will211/ESOE_Capstone_Embedded_System/README.md

# ESOE_Capstone_Embedded_System
 A self propelled boat campaign

 Route plan of autonomous ship via an infrared distance sensor
