will211/ESOE_Capstone_Embedded_System/Final-Report.pdf

# 工科專論期末報告格式

組員: 凃皓瑋 B06505001 朱紹勳 B06501018 陳威宇 B06204013 黃智遠 B06505049

1. 分工表:

組員 凃皓瑋: 船模設計

組員 朱紹勳: 程式、電路設計

組員 陳威宇: 程式、測試

組員 黃智遠: 打雜

2. 船體設計:

乾舷約為 5.15cm

吃水 1020g 時 GM 約為 2.13cm

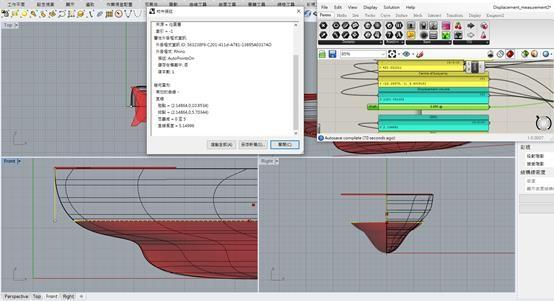
[picture p1: figure]
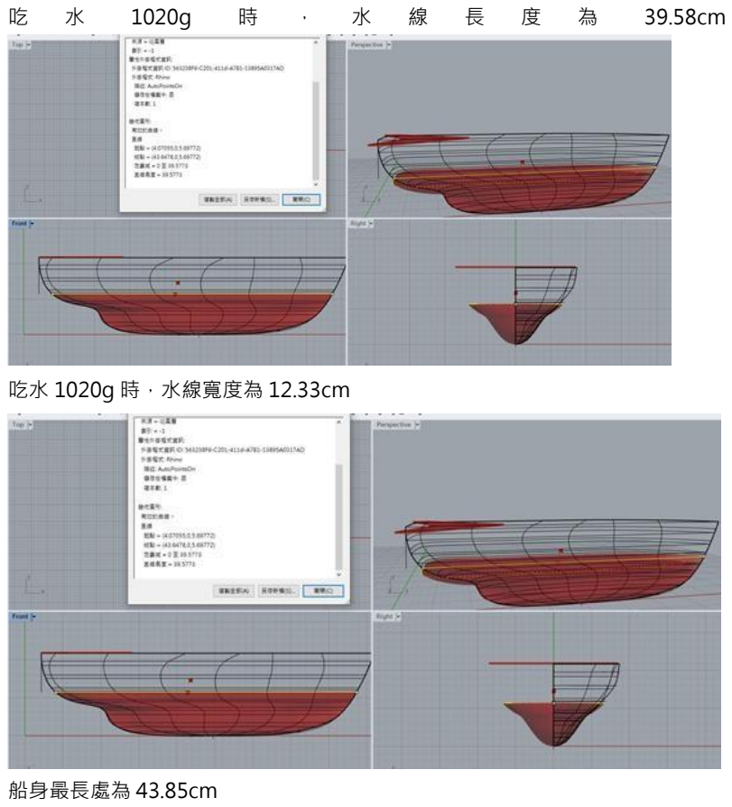
[picture p2: page 2]

吃 | 水 | 1020g | 時 | ， | 水 | 線 | 長 | 度 | 為 | 39.58cm

吃水 1020g 時，水線寬度為 12.33cm

船身最長處為 43.85cm

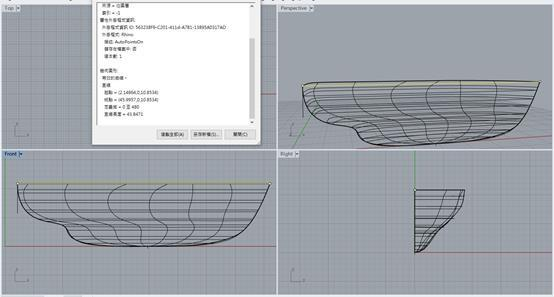
[picture p3: figure]

船體設計為下窄上寬，原因是為了保留螺槳空間以及增加 right arm 大小。

電路設計:
我們使用的 STM32F303RE 開發版，主要負責以下兩種功能: 超聲波感應與馬達 控制。

我們總共使用了五個超聲波感應器，為了避免超聲波錯誤的接收到其他發出的 trigger 信號而干擾，船頭設置一個(與船隻方向相同)，船身右前、左前、右後、 左後各設置一個(與船隻方向成 90 度)，彼此位置盡量拉開。

設計中，我們總共使用了七個 Timer，其中的五個 Timer: Timer2、Timer3、 Timer15、Timer16、Timer4，分別負責一個超聲波感測器的 echo 信號， Timer1 負責 interrupt 與 trigger 信號的發送；Timer8 下的兩個 channel 負責 兩個螺槳的旋轉。
以下表格顯示五個超聲波與對應 Timer，和 5V, Ground, trigger, echo 與 STM32 開發版的連接 pin 腳。

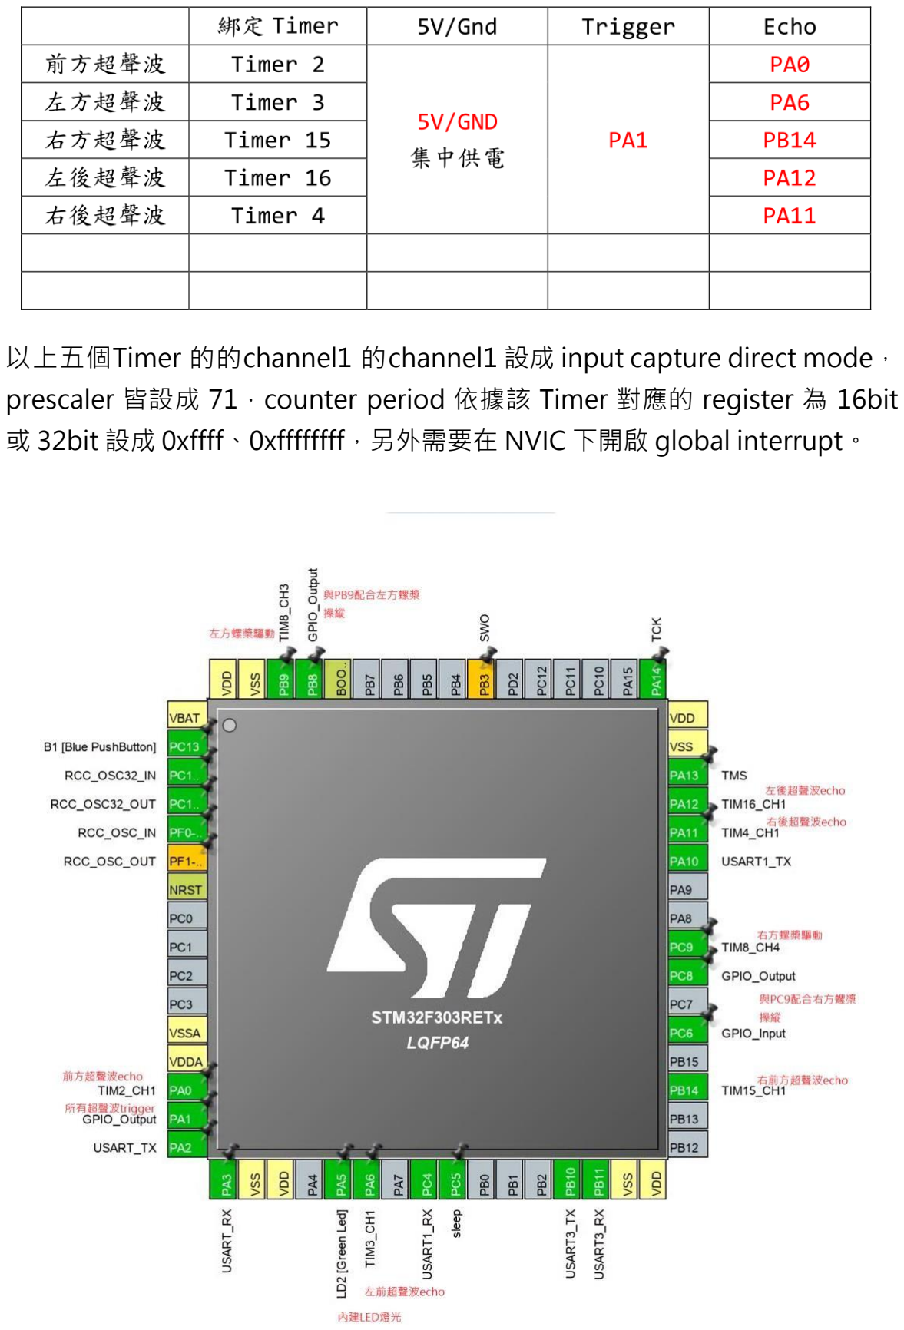
[picture p4: page 4]

以上五個Timer 的的channel1 的channel1 設成 input capture direct mode， prescaler 皆設成 71，counter period 依據該 Timer 對應的 register 為 16bit 或 32bit 設成 0xffff、0xffffffff，另外需要在 NVIC 下開啟 global interrupt。

Fig. 1 Schematic mapping

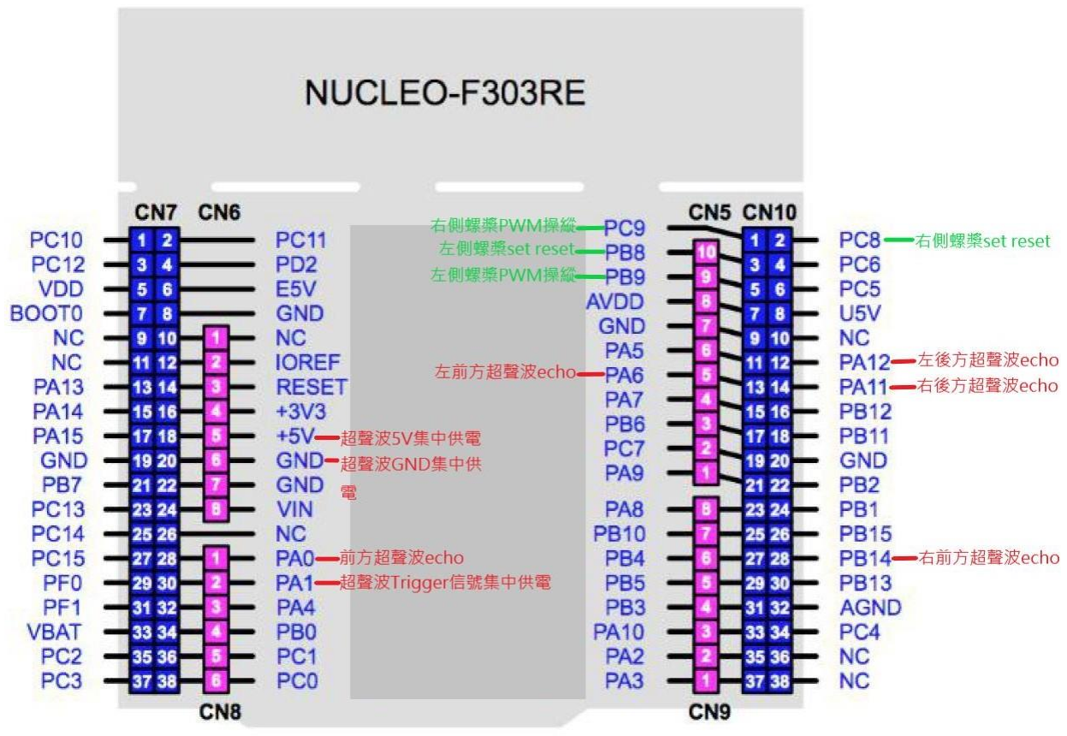
[picture p5: figure]

Fig. 2 STM32F303RE pinout map

針對學期初因應不同環境狀態寫成不同的 case，就我認為過於複雜，在測試除 錯上也會帶給我極大的困擾。這次的比賽賽道經過多次的調整，最終版的的容 錯餘裕度比較大，再加上船體本身設計穩定，因此我判斷簡單的演算法再加上 多次的事先測試就可以完成比賽需求。程式的演算法以前方距離為主要判斷基 礎，在不同距離下進行大小程度的左右轉彎、倒退等等。

Fig.3.1

圖 3.1 顯示C 語言的巨集，定義會使用到五個段位的馬達 PWM。經過測試，馬達 會在 PWM=70 實開始運作，然而 PWM 90 以上的加減速過大，所以不採用。

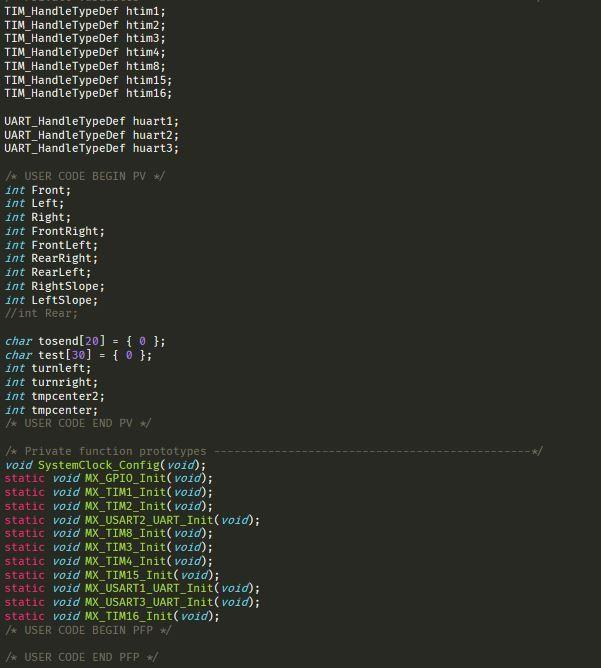
[picture p6: figure]

Fig.3.1

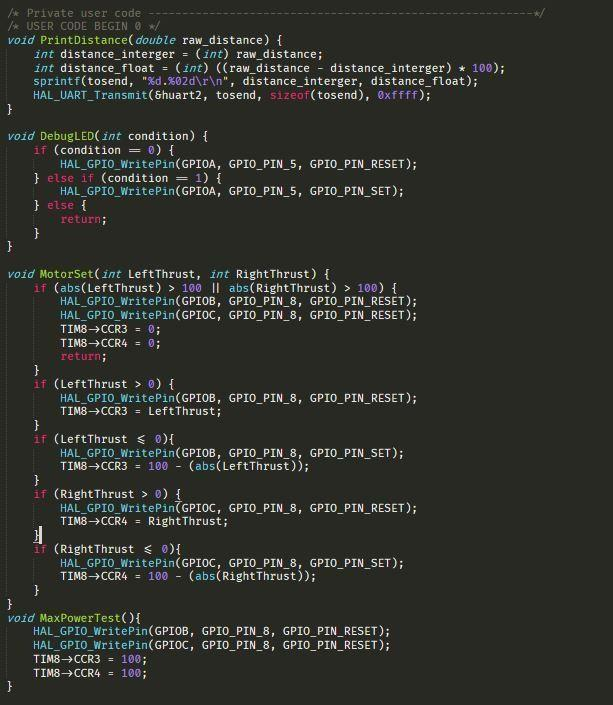
[picture p7: figure]

Fig.3.2 API

去年小組的自走車也是我負責，在工海專論中為了讓同學也能協助測試與調參， 特別將一些複雜的程式碼封裝起來，以減少同學在調整時的失誤。另外有善用 開發板上面的 LED 燈，將燈光亮案寫在某個程式區塊，以方便在測試時檢驗是否 有執行我們所預期的指令。另外在在連接電腦時，可以利用 serial port terminal 印出指定超聲波的距離。螺槳操縱上，有提供反轉的功能，實踐上就是 將與 timer6 channel 3,4 配合的 GPIO 設成高電位或低電位，並換算輸入的 PWM。

我在設計程式與實際測試中發現到，我必須確實的了解硬體狀態，例如接線、 電池、馬達、超聲波，並確保他們在每一次的正常運作；如此在船隻實際測試 發生不盡人意的表現時，才有可以信賴的判斷依據讓我找到出錯的關鍵點。

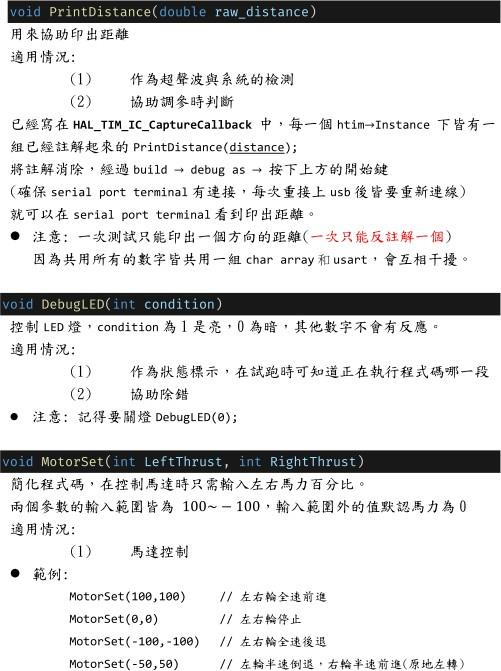
[picture p8: figure]

硬體檢測:
上電前

(一) 外部接線是否有脫落，對照上方腳位圖

驅動版是否接對(接在背面，四個 motor 接點朝下(stm32 LD1 為上)) (二) 電池需 1.4V 以上，才能保證效能

上電後
(三) 不定時檢查是否有發🗎(電線、感測器)、燒焦味
(四) 執行超聲波感測器檢測，依次註解消除 PrintDistance(distance) 是否走正確印出距離，每個超聲波感測器執行一次

編譯與燒錄
(五) 在 USB 供電、電池供電切換前
下電 → E5V 、 U5V 切換 → 上電

(六) 按下 debug as 後，是否進入 debug 頁面，LD1 是否有綠紅綠紅切換

以 上 | 是 | 測 | 試 | 前 | 會 | 進 | 行 | 的 | 確 | 認 | 動 | 作 | 。

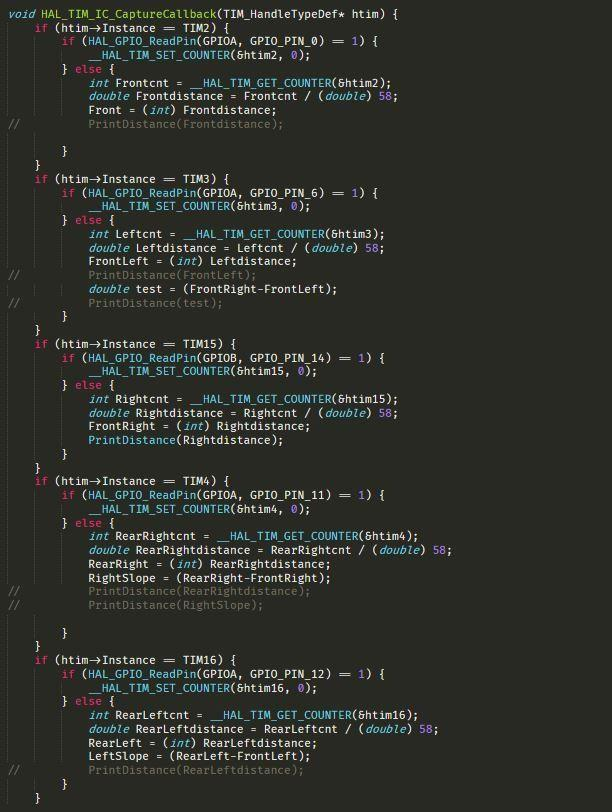
[picture p9: figure]

Fig.3.3 超聲波感測公式

五個超聲波共用 Timer1 的 interrupt 和 trigger 信號，並使用各自的 Timer 處 理 echo 信號。在收到回彈信號後，將 echo 拉到高戀位，觸發之後會提到的 HAL_TIM_IC_CatputeCallback ，並使用_HAL_TIM_SET_COUNTER(&htim,x)

將 counter register 設成 0；由於我們對於每一個超聲波的 input capture 訂為 both edge，隨後 echo 回到低電位時用_HAL_TIM_SET_COUNTER(&htimx)取 出 counter register 的值(等同於時間)，再用上換算公式得到距離。

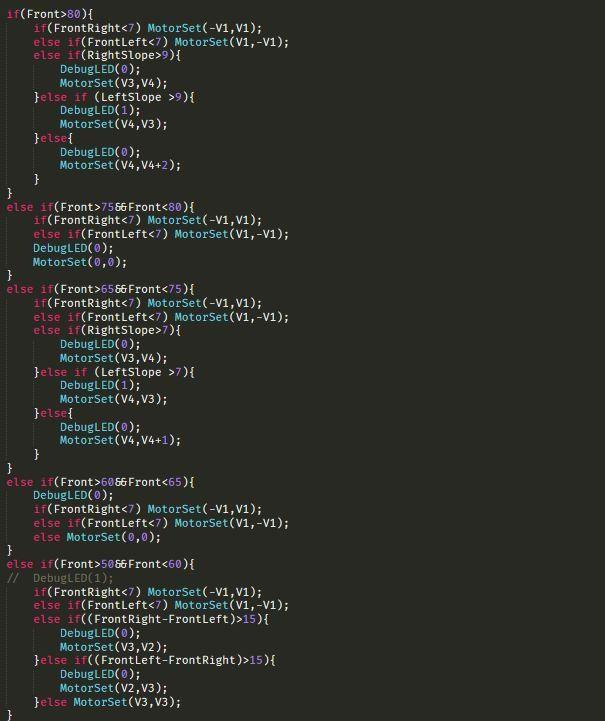
[picture p10: figure]

fig 3.4.1 距離判斷演算法

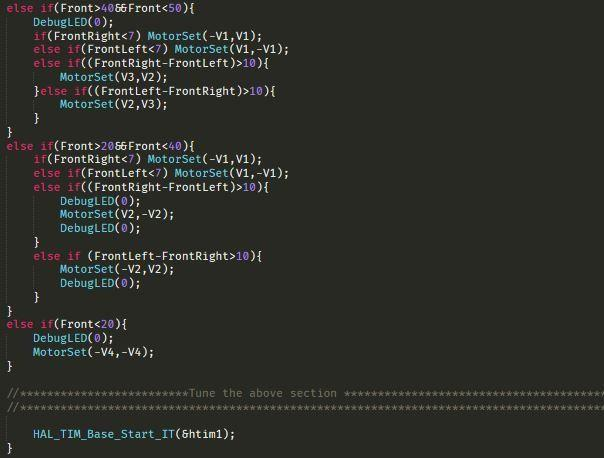
[picture p11: figure]

fig 3.4.2 距離判斷演算法

整個船隻的操縱主要分成幾個階段:
(1) 前方長距離
此時兩側螺槳以 PWM=85 的速度正走，並在兩種狀況下調整左右航向
(1) 左前左後之間、右前右後之間超生波距離相差太大 此演算法是避免在長距離時就發生 45 度擦撞的現象
(2) 左前 右前超聲波感測極短距離，此時極有可能擦撞牆壁 為了避免船頭接觸牆壁的摩擦力導致船首航向更偏離賽道
因此讓兩側螺槳轉向相反，盡量原地調整航向，避免繼續前進
(2) 前方中距離
我在其中的兩段五公分距離區間讓螺槳停止，以免船速在近距離時過快 因為進入直線航道，我停止使用左前左後之間、右前右後之間超生波距

離的判斷法，而是單純採取左前 右前超聲波感測距離的修正法。

(3) 前方中短距離

與中距離相似，但船速有所下降，並且旋轉幅度上升，使用原地旋轉

(4) 前方短距離

此時螺槳快速反轉，以期望減速避免正面碰撞

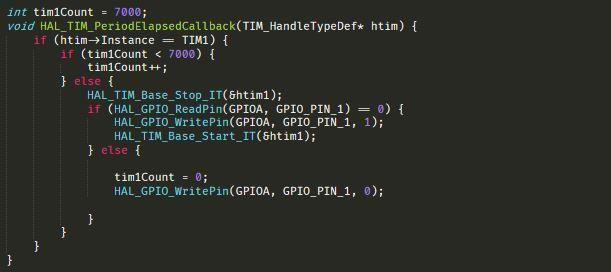
[picture p12: figure]

fig 3.4.2 Timer1 的 interrupt, callback 和 trigger

使用 counter ，當 counter<7000 ， 每一個 counter period 會出發一次 HAL_TIM_PeriodElapsedCallback。當 counter=7000，將 trigger 設定成高電 位促使所有超聲波發出感測距離的信號，並在下一個 counter period 時關閉 trigger 信號，同時 counter 設為 0 重新計數。

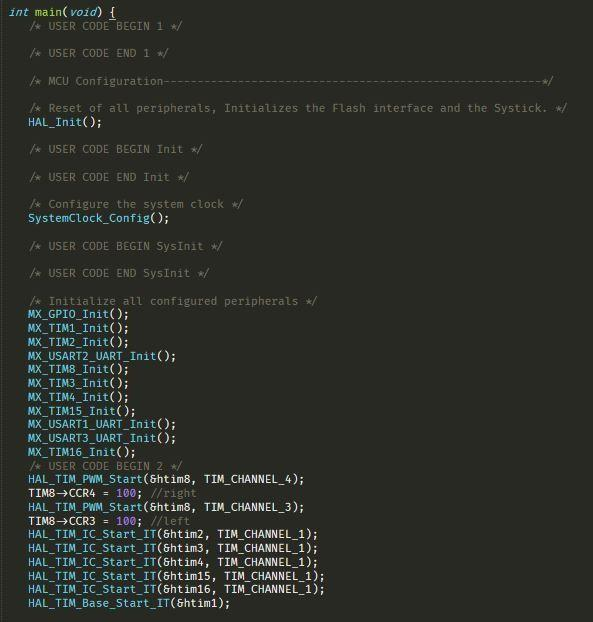
[picture p13: figure]

啟動 uart, Timer 與相對應 interrupt, GPIO 的程式碼。
