will211/ESOE_Capstone_Embedded_System/self_propelling_boat/Src/main.c

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

/* Includes ------------------------------------------------------------------*/
#include "main.h"
#define V1 70
#define V2 75
#define V3 80
#define V4 85
#define V5 90

TIM_HandleTypeDef htim1;
TIM_HandleTypeDef htim2;
TIM_HandleTypeDef htim3;
TIM_HandleTypeDef htim4;
TIM_HandleTypeDef htim8;
TIM_HandleTypeDef htim15;
TIM_HandleTypeDef htim16;

UART_HandleTypeDef huart1;
UART_HandleTypeDef huart2;
UART_HandleTypeDef huart3;

/* USER CODE BEGIN PV */
int Front;
int Left;
int Right;
int FrontRight;
int FrontLeft;
int RearRight;
int RearLeft;
int RightSlope;
int LeftSlope;
//int Rear;

char tosend[20] = { 0 };
char test[30] = { 0 };
int turnleft;
int turnright;
int tmpcenter2;
int tmpcenter;
/* USER CODE END PV */

void SystemClock_Config(void);
static void MX_GPIO_Init(void);
static void MX_TIM1_Init(void);
static void MX_TIM2_Init(void);
static void MX_USART2_UART_Init(void);
static void MX_TIM8_Init(void);
static void MX_TIM3_Init(void);
static void MX_TIM4_Init(void);
static void MX_TIM15_Init(void);
static void MX_USART1_UART_Init(void);
static void MX_USART3_UART_Init(void);
static void MX_TIM16_Init(void);
/* USER CODE BEGIN 0 */
void PrintDistance(double raw_distance) {
	int distance_interger = (int) raw_distance;
	int distance_float = (int) ((raw_distance - distance_interger) * 100);
	sprintf(tosend, "%d.%02d\r\n", distance_interger, distance_float);
	HAL_UART_Transmit(&huart2, tosend, sizeof(tosend), 0xffff);
}

void DebugLED(int condition) {
	if (condition == 0) {
		HAL_GPIO_WritePin(GPIOA, GPIO_PIN_5, GPIO_PIN_RESET);
	} else if (condition == 1) {
		HAL_GPIO_WritePin(GPIOA, GPIO_PIN_5, GPIO_PIN_SET);
	} else {
		return;
	}
}

void MotorSet(int RightThrust, int LeftThrust) {
	if (abs(LeftThrust) > 100 || abs(RightThrust) > 100) {
		HAL_GPIO_WritePin(GPIOB, GPIO_PIN_8, GPIO_PIN_RESET);
		HAL_GPIO_WritePin(GPIOC, GPIO_PIN_8, GPIO_PIN_RESET);
		TIM8->CCR3 = 0;
		TIM8->CCR4 = 0;
		return;
	}
	if (LeftThrust > 0) {
		HAL_GPIO_WritePin(GPIOB, GPIO_PIN_8, GPIO_PIN_RESET);
		TIM8->CCR3 = LeftThrust;
	}
	if (LeftThrust <= 0){
		HAL_GPIO_WritePin(GPIOB, GPIO_PIN_8, GPIO_PIN_SET);
		TIM8->CCR3 = 100 - (abs(LeftThrust));
	}
	if (RightThrust > 0) {
		HAL_GPIO_WritePin(GPIOC, GPIO_PIN_8, GPIO_PIN_RESET);
		TIM8->CCR4 = RightThrust;
	}
	if (RightThrust <= 0){
		HAL_GPIO_WritePin(GPIOC, GPIO_PIN_8, GPIO_PIN_SET);
		TIM8->CCR4 = 100 - (abs(RightThrust));
	}
}
void MaxPowerTest(){
	HAL_GPIO_WritePin(GPIOB, GPIO_PIN_8, GPIO_PIN_RESET);
	HAL_GPIO_WritePin(GPIOC, GPIO_PIN_8, GPIO_PIN_RESET);
	TIM8->CCR3 = 100;
	TIM8->CCR4 = 100;
}

void HAL_TIM_IC_CaptureCallback(TIM_HandleTypeDef* htim) {
	if (htim->Instance == TIM2) {
		if (HAL_GPIO_ReadPin(GPIOA, GPIO_PIN_0) == 1) {
			__HAL_TIM_SET_COUNTER(&htim2, 0);
		} else {
			int Frontcnt = __HAL_TIM_GET_COUNTER(&htim2);
			double Frontdistance = Frontcnt / (double) 58;
			Front = (int) Frontdistance;
//			PrintDistance(Frontdistance);

		}
	}
	if (htim->Instance == TIM3) {
		if (HAL_GPIO_ReadPin(GPIOA, GPIO_PIN_6) == 1) {
			__HAL_TIM_SET_COUNTER(&htim3, 0);
		} else {
			int Leftcnt = __HAL_TIM_GET_COUNTER(&htim3);
			double Leftdistance = Leftcnt / (double) 58;
			FrontLeft = (int) Leftdistance;
//			PrintDistance(FrontLeft);
			double test = (FrontRight-FrontLeft);
//			PrintDistance(test);
		}
	}
	if (htim->Instance == TIM15) {
		if (HAL_GPIO_ReadPin(GPIOB, GPIO_PIN_14) == 1) {
			__HAL_TIM_SET_COUNTER(&htim15, 0);
		} else {
			int Rightcnt = __HAL_TIM_GET_COUNTER(&htim15);
			double Rightdistance = Rightcnt / (double) 58;
			FrontRight = (int) Rightdistance;
			PrintDistance(Rightdistance);
		}
	}
	if (htim->Instance == TIM4) {
		if (HAL_GPIO_ReadPin(GPIOA, GPIO_PIN_11) == 1) {
			__HAL_TIM_SET_COUNTER(&htim4, 0);
		} else {
			int RearRightcnt = __HAL_TIM_GET_COUNTER(&htim4);
			double RearRightdistance = RearRightcnt / (double) 58;
			RearRight = (int) RearRightdistance;
			RightSlope = (RearRight-FrontRight);
//			PrintDistance(RearRightdistance);
//			PrintDistance(RightSlope);

		}
	}
	if (htim->Instance == TIM16) {
		if (HAL_GPIO_ReadPin(GPIOA, GPIO_PIN_12) == 1) {
			__HAL_TIM_SET_COUNTER(&htim16, 0);
		} else {
			int RearLeftcnt = __HAL_TIM_GET_COUNTER(&htim16);
			double RearLeftdistance = RearLeftcnt / (double) 58;
			RearLeft = (int) RearLeftdistance;
			LeftSlope = (RearLeft-FrontLeft);
//			PrintDistance(RearLeftdistance);
		}
	}

//********************************************************************************************
//*************************Tune the following section ****************************************
if(Front<20){
		DebugLED(0);
		MotorSet(-V4,-V4);
}

else if(Front>80){
	if(FrontRight<7) MotorSet(-V1,V1);
	else if(FrontLeft<7) MotorSet(V1,-V1);
	else if(RightSlope>9){
		DebugLED(0);
		MotorSet(V3,V4);
	}else if (LeftSlope >9){
		DebugLED(1);
		MotorSet(V4,V3);
	}else{
		DebugLED(0);
		MotorSet(V4,V4+2);
	}
}
else if(Front>75&&Front<80){
	if(FrontRight<7) MotorSet(-V1,V1);
	else if(FrontLeft<7) MotorSet(V1,-V1);
	DebugLED(0);
	MotorSet(0,0);
}
else if(Front>65&&Front<75){
	if(FrontRight<7) MotorSet(-V1,V1);
	else if(FrontLeft<7) MotorSet(V1,-V1);
	else if(RightSlope>7){
		DebugLED(0);
		MotorSet(V3,V4);
	}else if (LeftSlope >7){
		DebugLED(1);
		MotorSet(V4,V3);
	}else{
		DebugLED(0);
		MotorSet(V4,V4+1);
	}
}
else if(Front>60&&Front<65){
	DebugLED(0);
	if(FrontRight<7) MotorSet(-V1,V1);
	else if(FrontLeft<7) MotorSet(V1,-V1);
	else MotorSet(0,0);
}
else if(Front>50&&Front<60){
//	DebugLED(1);
	if(FrontRight<7) MotorSet(-V1,V1);
	else if(FrontLeft<7) MotorSet(V1,-V1);
	else if((FrontRight-FrontLeft)>15){
		DebugLED(0);
		MotorSet(V3,V2);
	}else if((FrontLeft-FrontRight)>15){
		DebugLED(0);
		MotorSet(V2,V3);
	}else MotorSet(V3,V3);
}
else if(Front>40&&Front<50){
	DebugLED(0);
	if(FrontRight<7) MotorSet(-V1,V1);
	else if(FrontLeft<7) MotorSet(V1,-V1);
	else if((FrontRight-FrontLeft)>10){
		MotorSet(V3,V2);
	}else if((FrontLeft-FrontRight)>10){
		MotorSet(V2,V3);
	}
}
else if(Front>20&&Front<40){
	if(FrontRight<7) MotorSet(-V1,V1);
	else if(FrontLeft<7) MotorSet(V1,-V1);
	else if((FrontRight-FrontLeft)>10){
		DebugLED(0);
		MotorSet(V2,-V2);
		DebugLED(0);
	}
	else if (FrontLeft-FrontRight>10){
		MotorSet(-V2,V2);
		DebugLED(0);
	}
}

//*************************Tune the above section ********************************************
//********************************************************************************************

	HAL_TIM_Base_Start_IT(&htim1);
}


int tim1Count = 7000;
void HAL_TIM_PeriodElapsedCallback(TIM_HandleTypeDef* htim) {
	if (htim->Instance == TIM1) {
		if (tim1Count < 7000) {
			tim1Count++;
		} else {
			HAL_TIM_Base_Stop_IT(&htim1);
			if (HAL_GPIO_ReadPin(GPIOA, GPIO_PIN_1) == 0) {
				HAL_GPIO_WritePin(GPIOA, GPIO_PIN_1, 1);
				HAL_TIM_Base_Start_IT(&htim1);
			} else {

				tim1Count = 0;
				HAL_GPIO_WritePin(GPIOA, GPIO_PIN_1, 0);

			}
		}
	}
}

/* USER CODE END 0 */

 int main(void) {
	/* MCU Configuration--------------------------------------------------------*/

	/* Reset of all peripherals, Initializes the Flash interface and the Systick. */
	HAL_Init();

	/* Configure the system clock */
	SystemClock_Config();

	/* Initialize all configured peripherals */
	MX_GPIO_Init();
	MX_TIM1_Init();
	MX_TIM2_Init();
	MX_USART2_UART_Init();
	MX_TIM8_Init();
	MX_TIM3_Init();
	MX_TIM4_Init();
	MX_TIM15_Init();
	MX_USART1_UART_Init();
	MX_USART3_UART_Init();
	MX_TIM16_Init();
	/* USER CODE BEGIN 2 */
	HAL_TIM_PWM_Start(&htim8, TIM_CHANNEL_4);
	TIM8->CCR4 = 100; //right
	HAL_TIM_PWM_Start(&htim8, TIM_CHANNEL_3);
	TIM8->CCR3 = 100; //left
	HAL_TIM_IC_Start_IT(&htim2, TIM_CHANNEL_1);
	HAL_TIM_IC_Start_IT(&htim3, TIM_CHANNEL_1);
	HAL_TIM_IC_Start_IT(&htim4, TIM_CHANNEL_1);
	HAL_TIM_IC_Start_IT(&htim15, TIM_CHANNEL_1);
	HAL_TIM_IC_Start_IT(&htim16, TIM_CHANNEL_1);
	HAL_TIM_Base_Start_IT(&htim1);

	/* USER CODE END 2 */

	/* Infinite loop */
	/* USER CODE BEGIN WHILE */
	while (1) {
//		/* USER CODE END WHILE */
//		if (Right < 10){
//			MotorSet(0, 75);
//		}
//		if (Left < 10){
//			MotorSet(75,0);
//		}



		/* USER CODE BEGIN 3 */
//	  char buf[20] = "";
//	  sprintf(buf,"Hello!");
//	  HAL_UART_Transmit(&huart2,buf,sizeof(buf),0xffff);
//	  HAL_Delay(10);
	}
	/* USER CODE END 3 */
}

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
