will211/ESOE_Capstone_Embedded_System/self_propelling_boat/microwave1/microwave1.ioc

Mcu.UserName=STM32F303RETx
PA0.Signal=S_TIM2_CH1_ETR
PA1.Signal=GPIO_Output
PA11.Signal=S_TIM4_CH1
PA13.GPIO_Label=TMS
PA13.Signal=SYS_JTMS-SWDIO
PA14.GPIO_Label=TCK
PA14.Signal=SYS_JTCK-SWCLK
PA2.GPIO_Label=USART_TX
PA2.Signal=USART2_TX
PA3.GPIO_Label=USART_RX
PA3.Signal=USART2_RX
PA5.GPIO_Label=LD2 [Green Led]
PA5.Signal=GPIO_Output
PA6.Signal=S_TIM3_CH1
PB3.GPIO_Label=SWO
PB3.Signal=SYS_JTDO-TRACESWO
PB8.Signal=GPIO_Output
PB9.Signal=S_TIM8_CH3
PC13.GPIO_Label=B1 [Blue PushButton]
PC13.Signal=GPXTI13
PC14-OSC32_IN.Signal=RCC_OSC32_IN
PC15-OSC32_OUT.Signal=RCC_OSC32_OUT
PC5.GPIO_Label=sleep
PC5.Signal=GPIO_Output
PC6.Signal=GPIO_Input
PC8.Signal=GPIO_Output
PC9.Signal=S_TIM8_CH4
PF0-OSC_IN.Signal=RCC_OSC_IN
PF1-OSC_OUT.Signal=RCC_OSC_OUT
