will211/ESOE_Capstone_Embedded_System/self_propelling_boat/Inc/main.h

#define B1_Pin GPIO_PIN_13
#define B1_GPIO_Port GPIOC
#define USART_TX_Pin GPIO_PIN_2
#define USART_TX_GPIO_Port GPIOA
#define USART_RX_Pin GPIO_PIN_3
#define USART_RX_GPIO_Port GPIOA
#define LD2_Pin GPIO_PIN_5
#define LD2_GPIO_Port GPIOA
#define USART1_RX_Pin GPIO_PIN_4
#define USART1_RX_GPIO_Port GPIOC
#define sleep_Pin GPIO_PIN_5
#define sleep_GPIO_Port GPIOC
#define USART3_TX_Pin GPIO_PIN_10
#define USART3_TX_GPIO_Port GPIOB
#define USART3_RX_Pin GPIO_PIN_11
#define USART3_RX_GPIO_Port GPIOB
#define USART1_TX_Pin GPIO_PIN_10
#define USART1_TX_GPIO_Port GPIOA
#define TMS_Pin GPIO_PIN_13
#define TMS_GPIO_Port GPIOA
#define TCK_Pin GPIO_PIN_14
#define TCK_GPIO_Port GPIOA
#define SWO_Pin GPIO_PIN_3
#define SWO_GPIO_Port GPIOB
